upenn-embedded/final-project-website-submission-f25-t07-f25-veloguard/images/3Dprint2.jpg

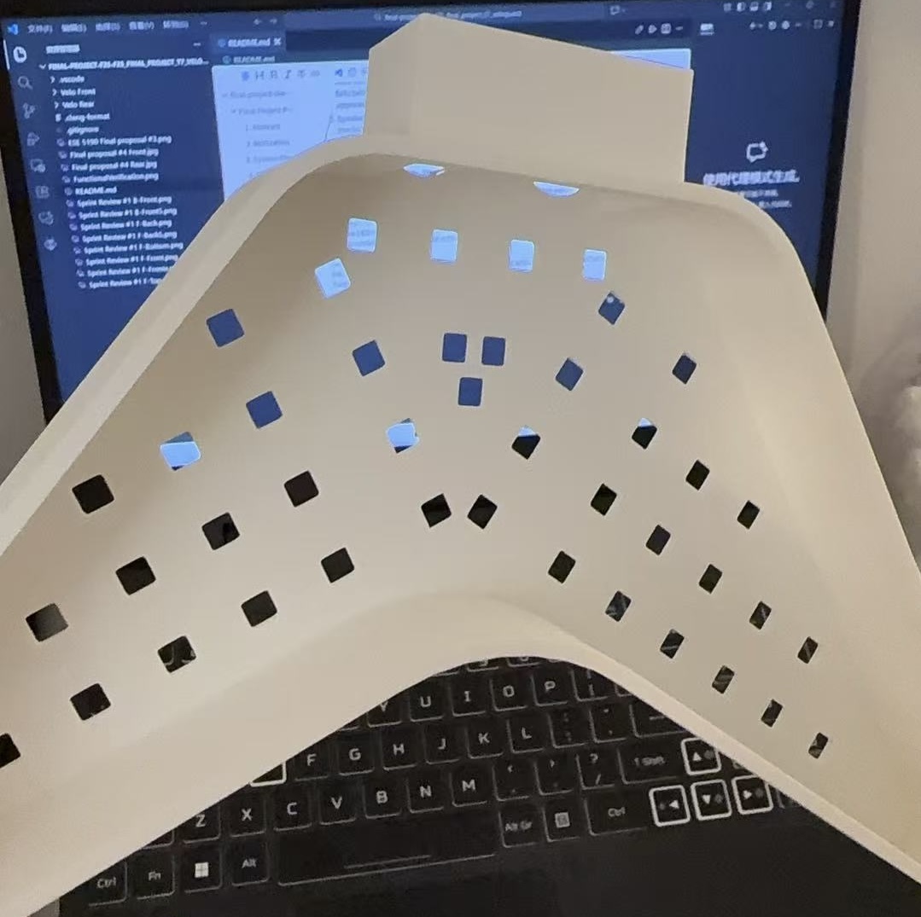
images/3Dprint2.jpg
