upenn-embedded/final-project-website-submission-f25-t07-f25-veloguard/images/ESE 5190 Final proposal #3.png

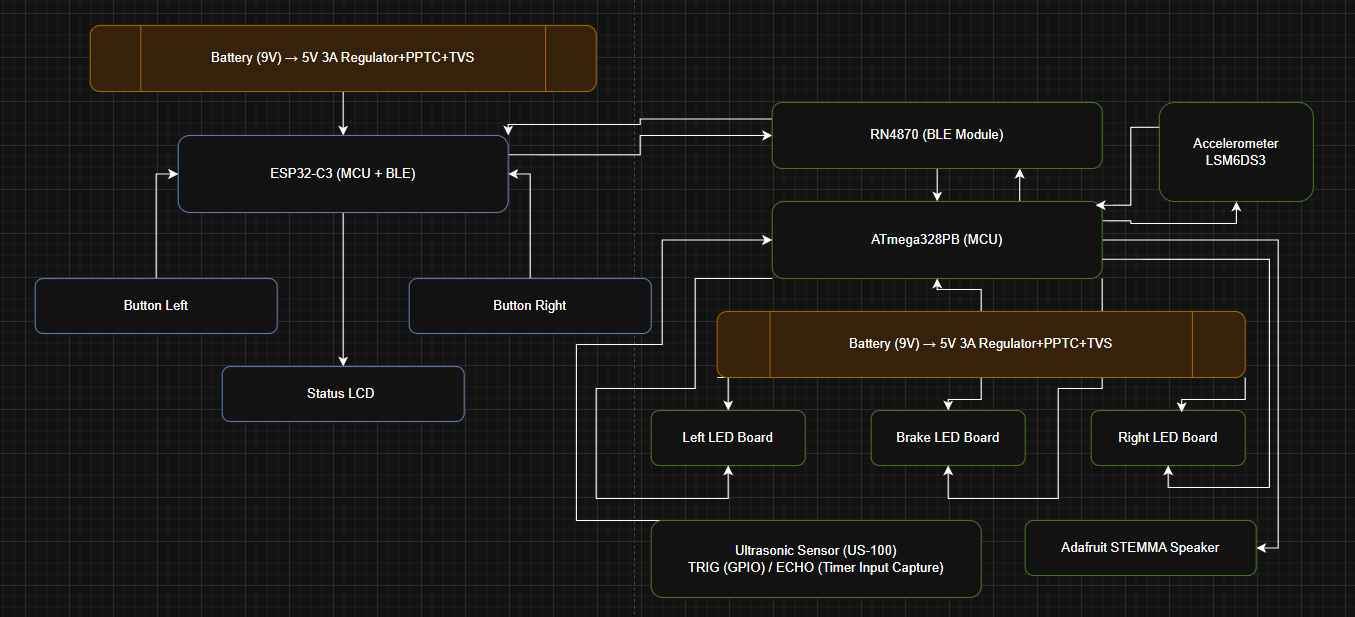
images/ESE 5190 Final proposal #3.png
