upenn-embedded/final-project-website-submission-f25-t07-f25-veloguard/images/Sprint Review #1 F-Back.png

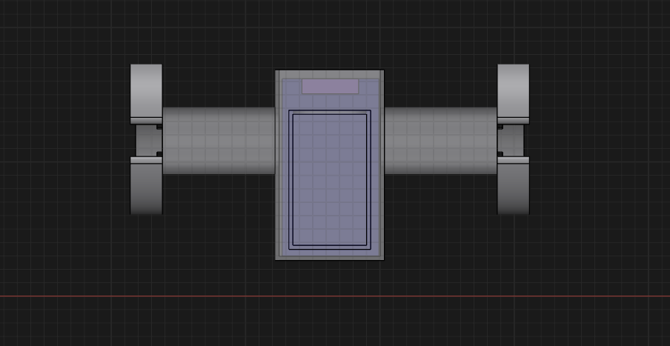
images/Sprint Review #1 F-Back.png
