upenn-embedded/final-project-website-submission-f25-t07-f25-veloguard/Velo Front/state_machine.h

#ifndef STATE_MACHINE_H
#define STATE_MACHINE_H

#include "common.h"

void state_machine_init(void);
void state_machine_on_input(input_event_t evt);
void state_machine_on_link_loss(bool lost);
bike_mode_t state_machine_get_mode(void);

#endif
