upenn-embedded/final-project-website-submission-f25-t07-f25-veloguard/Velo Rear/include/turn_led.h

// #ifndef TURN_LED_H
// #define TURN_LED_H

// #include "common.h"
// #include <stdint.h>

// void turn_led_init(void);

// // Set which groups (0-5) should be lit; phase >= TOTAL_GROUPS turns off all
// void turn_led_set_group(uint8_t phase, int mask);

// // Update turn LED animation based on turn mode (LEFT/RIGHT/NONE)
// void turn_led_update(rear_turn_mode_t mode);

// #endif
